dkstiler/printcart/check_waveform/README.txt

This actually is most bits of the esphttpd example code, hence references to un-used cats,
cgi scripts etc. The important bits are i2s_parallel.c and cgi-waveform.c.
