dkstiler/printcart/integrated/main/whe.png

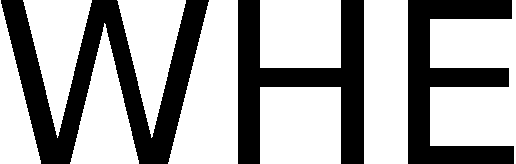
integrated/main/whe.png
