dkstiler/printcart/integrated/components/magicbrush/magicbrush-schematic.pdf

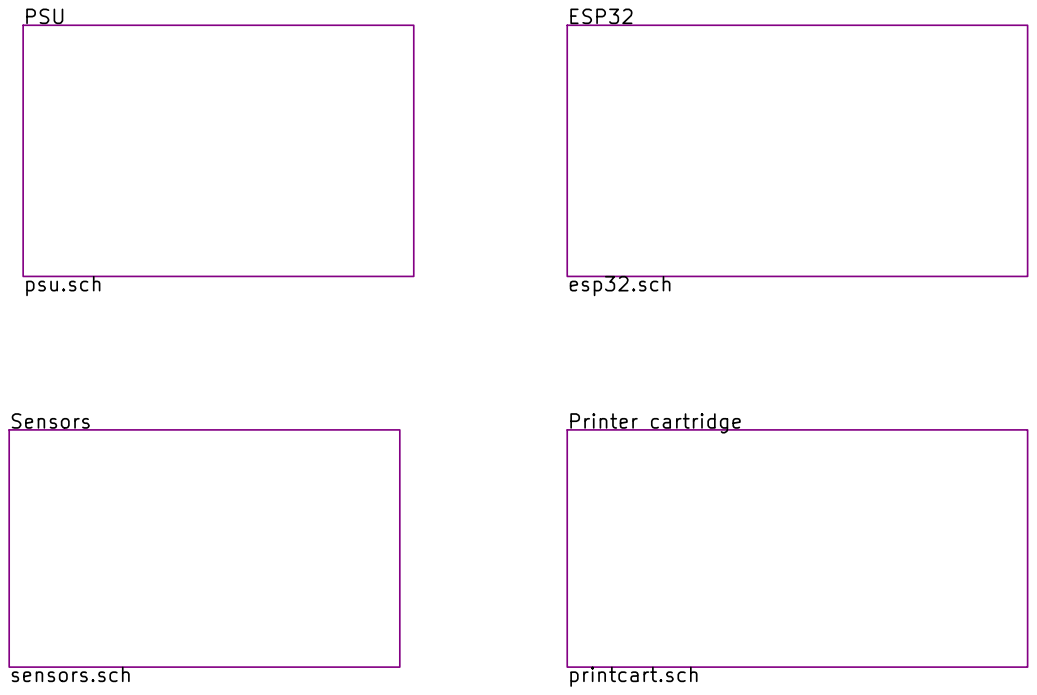
[picture p2: page 1]

File: magicbrush.sch Sheet: /
Id: 1/5 Title:

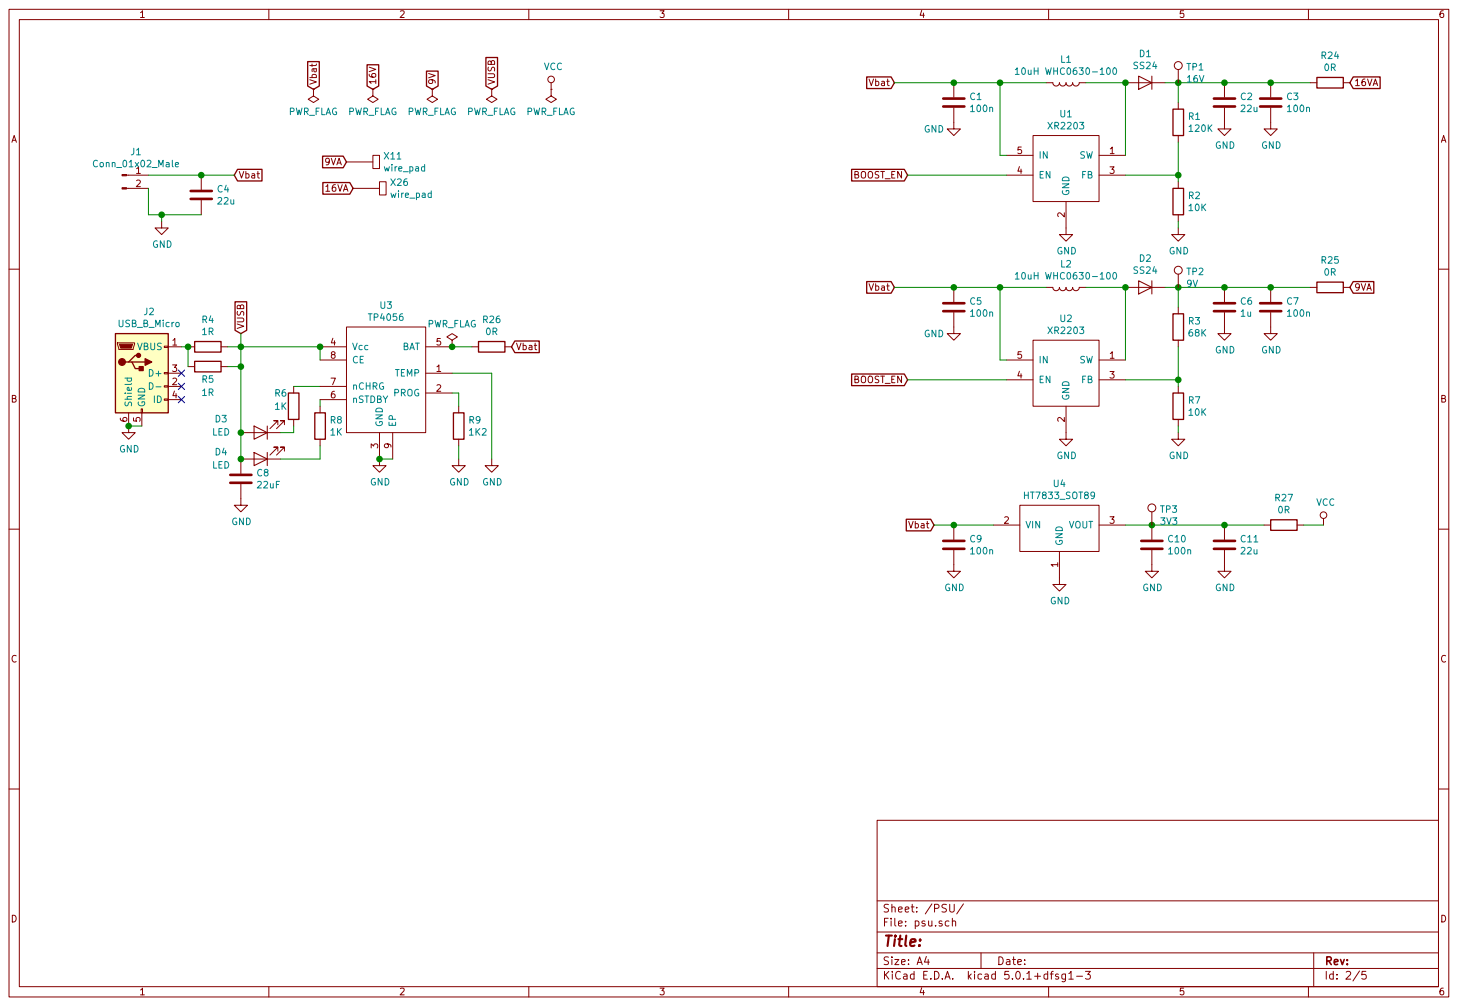
[picture p3: page 2]

File: psu.sch Sheet: /PSU/
Id: 2/5 Title:

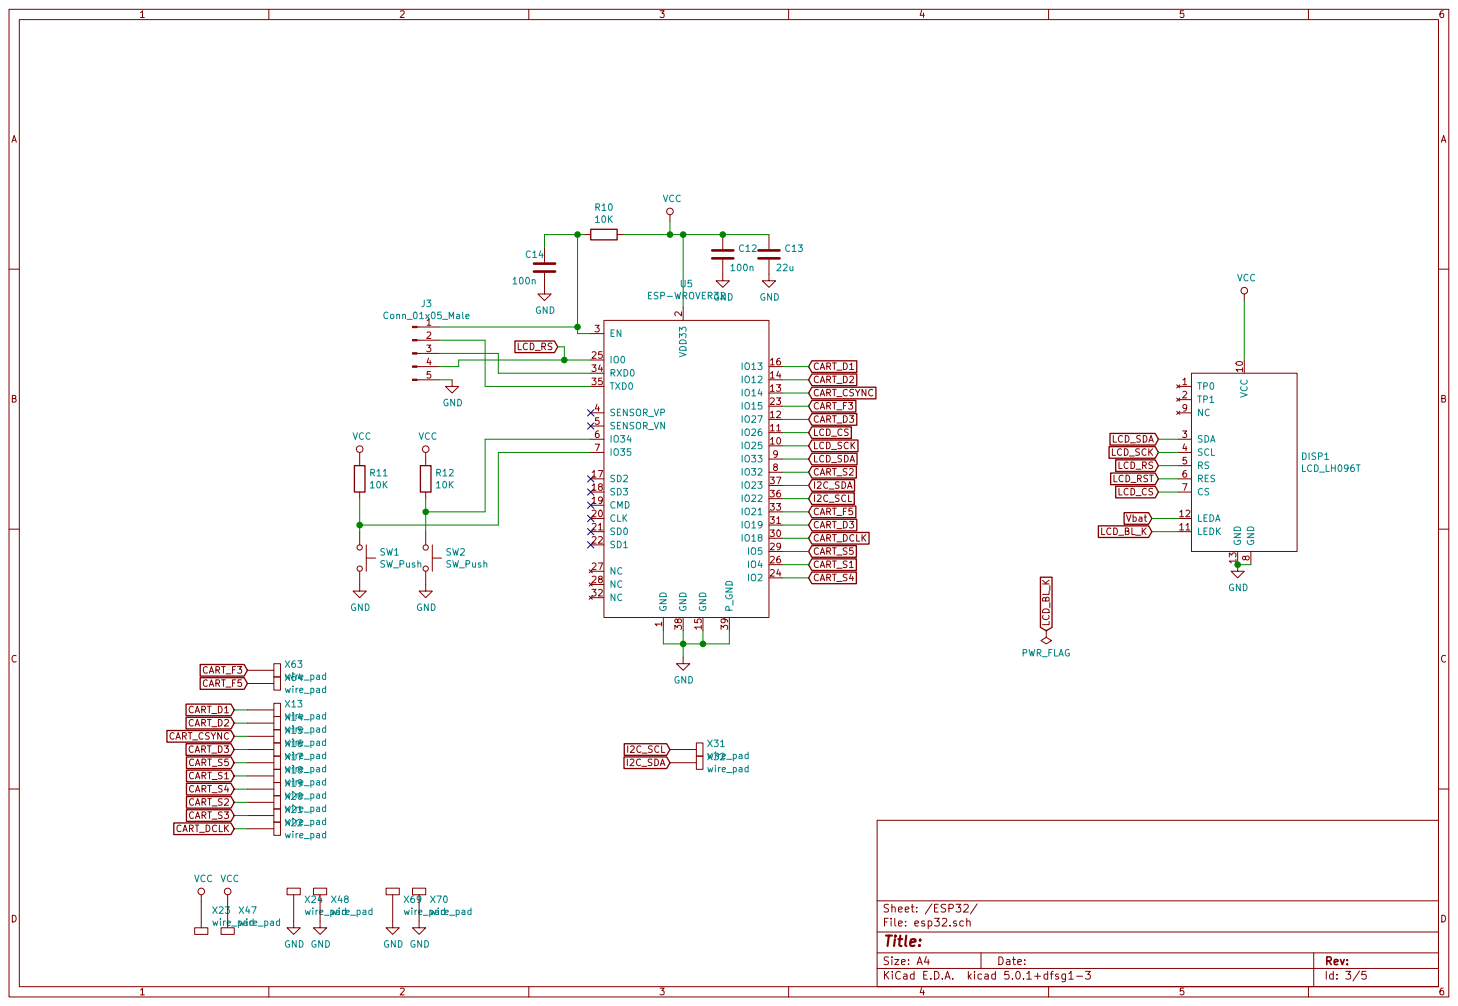
[picture p4: page 3]

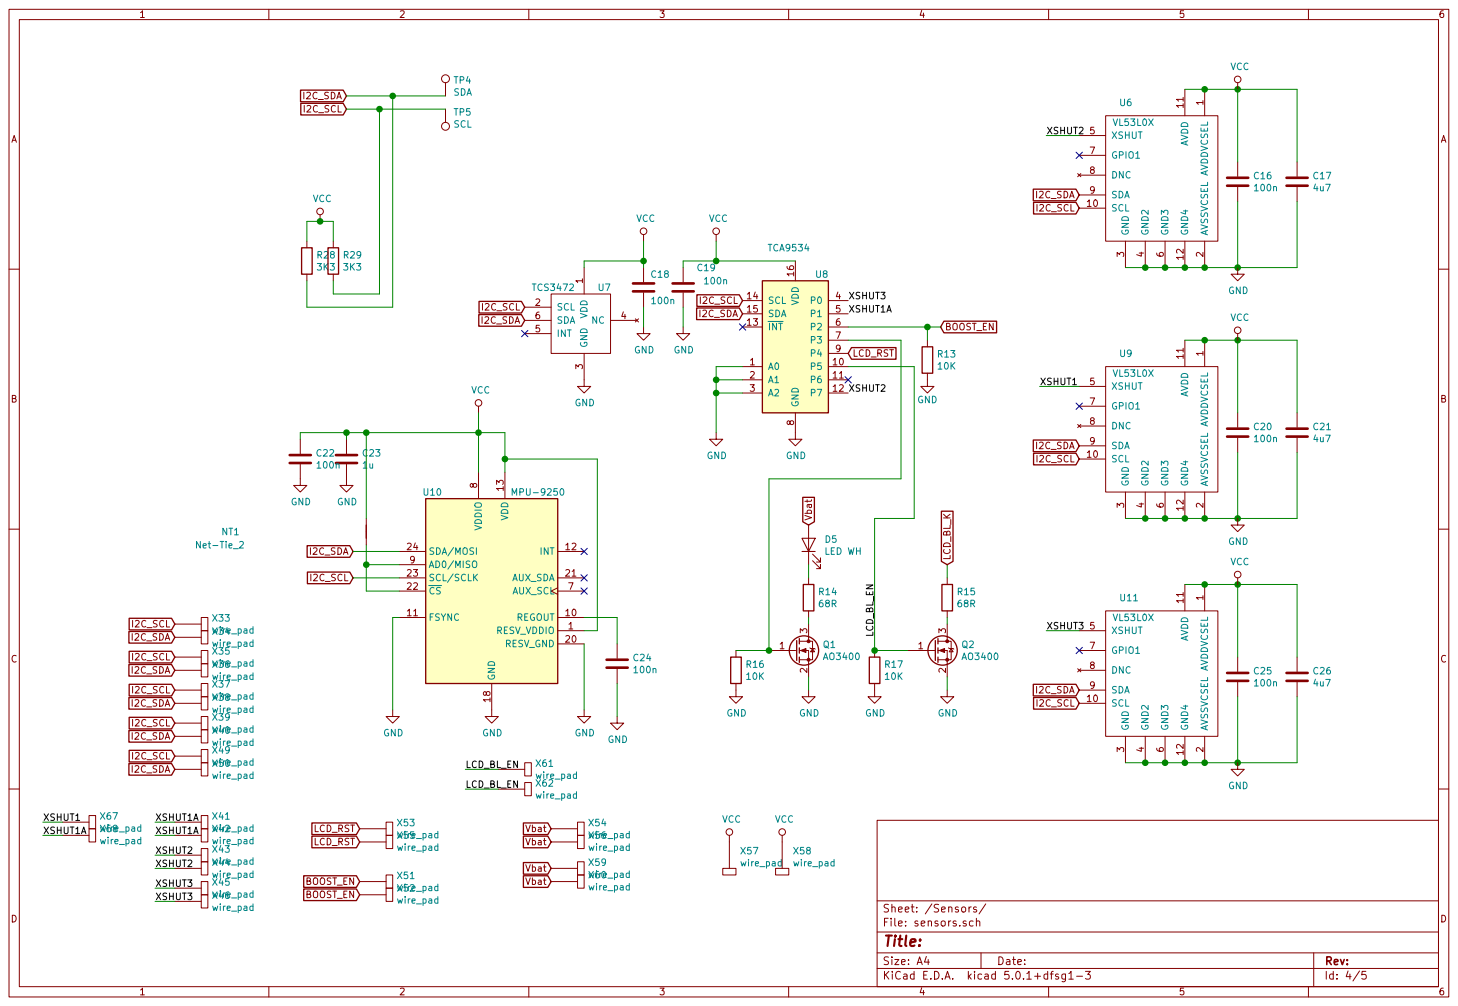
[picture p5: page 4]

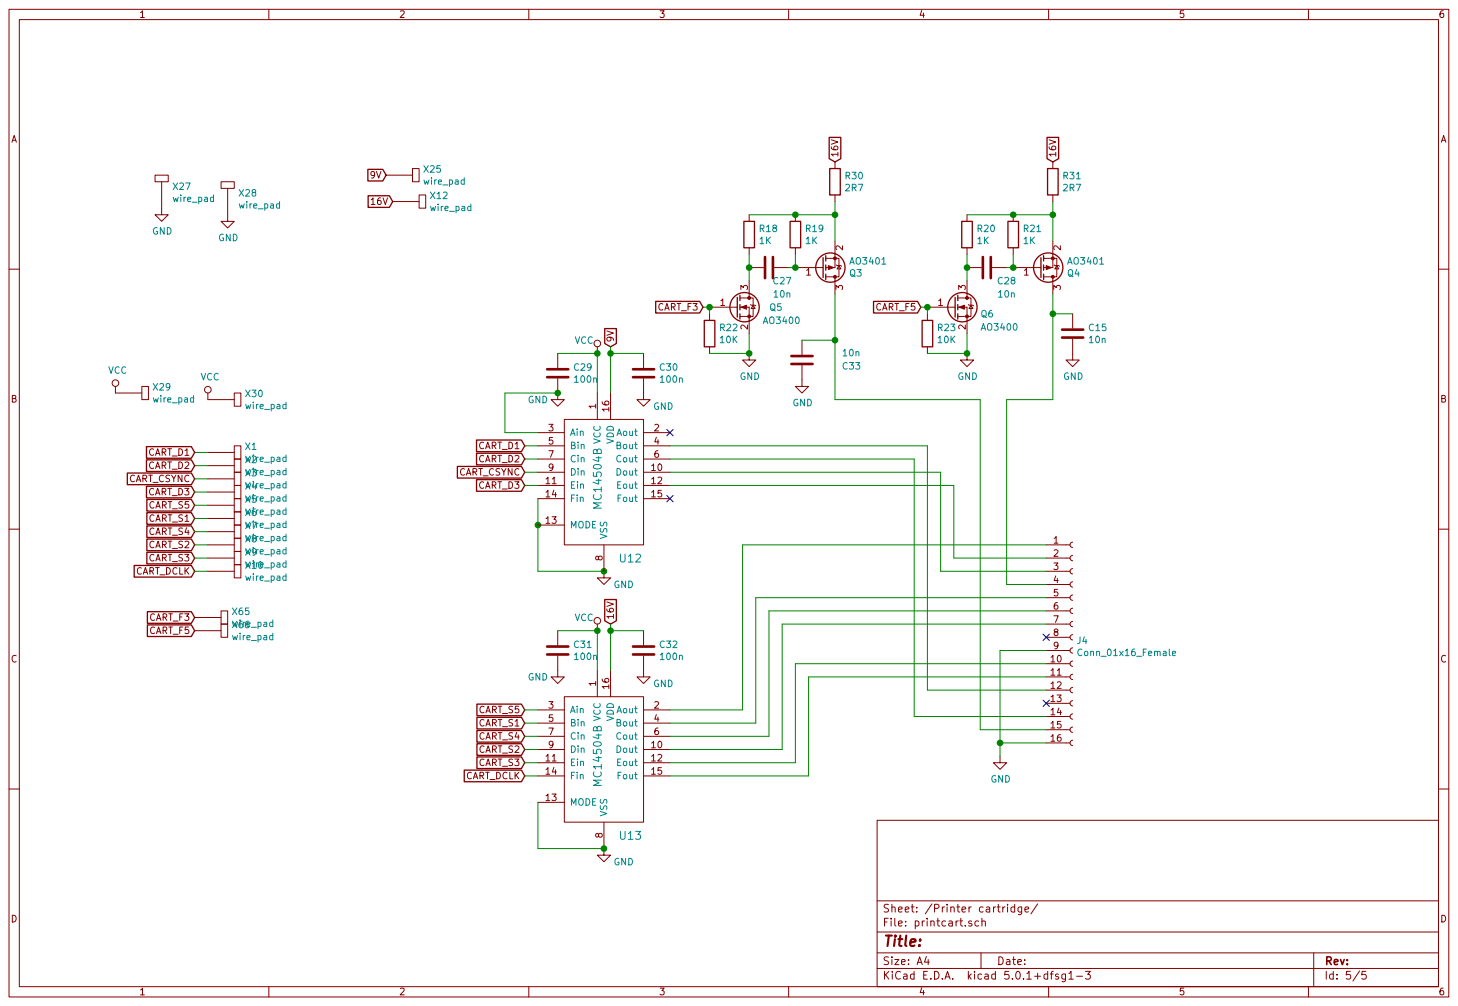
[picture p6: page 5]
