dkstiler/printcart/integrated/components/magicbrush/magicbrush.kicad_pcb

## KiCad design integrated/components/magicbrush/magicbrush.kicad_pcb (2025-09-18)

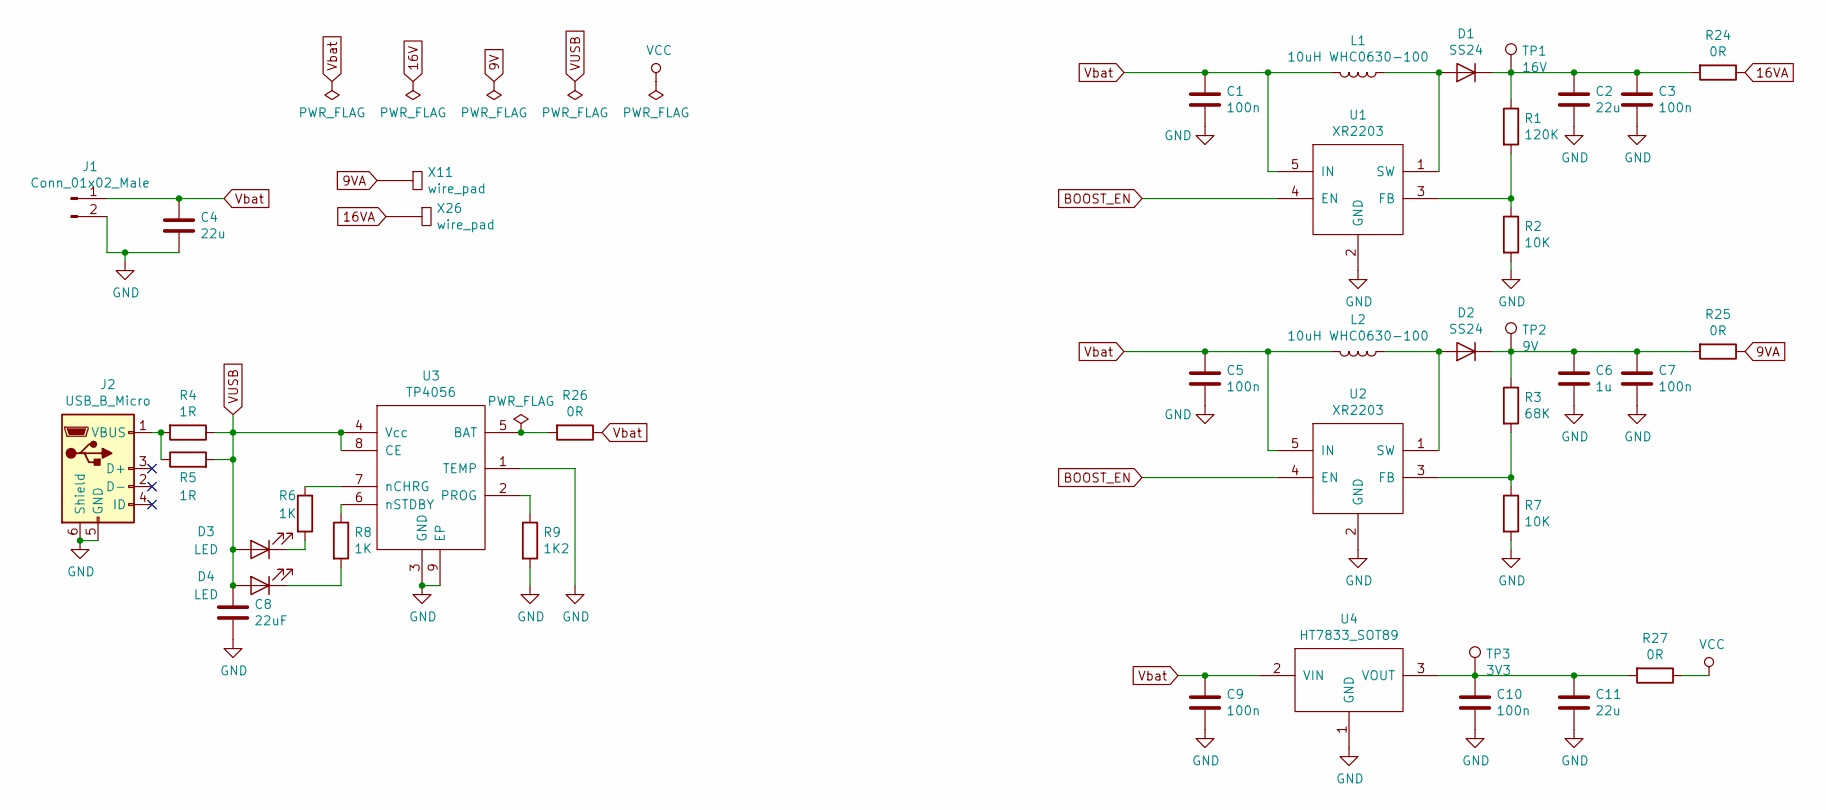
[picture p7: schematic psu.sch]

Parts:
C1, C3, C5, C7, C9, C10: 100n; C_0603_1608Metric_Pad1.05x0.95mm_HandSolder
C2, C4, C11: 22u; C_0805_2012Metric_Pad1.15x1.40mm_HandSolder
C6: 1u; C_0603_1608Metric_Pad1.05x0.95mm_HandSolder
C8: 22uF; C_0805_2012Metric_Pad1.15x1.40mm_HandSolder
D1, D2: SS24; D_SMB_Handsoldering
D3, D4: LED; LED_0603_1608Metric_Pad1.05x0.95mm_HandSolder
J1: Conn_01x02_Male; PinHeader_1x02_P2.54mm_Vertical
J2: USB_B_Micro; USB_Micro-B_0.8mm_taobao
L1, L2: 10uH WHC0630-100; IND_WHC0630
R1: 120K; R_0603_1608Metric
R2, R7: 10K; R_0603_1608Metric
R3: 68K; R_0603_1608Metric
R4, R5: 1R; R_0603_1608Metric
R6, R8: 1K; R_0603_1608Metric
R9: 1K2; R_0603_1608Metric
R24, R25, R26, R27: 0R; R_0603_1608Metric_Pad1.05x0.95mm_HandSolder
TP1: 16V; TestPoint_Pad_D1.5mm
TP2: 9V; TestPoint_Pad_D1.5mm
TP3: 3V3; TestPoint_Pad_D1.5mm
U1, U2: XR2203; SOT-23-5
U3: TP4056; SOIC-8-1EP_3.9x4.9mm_P1.27mm_EP2.35x2.35mm
U4: HT7833_SOT89; SOT-89-3
X11, X26: wire_pad; wire_pad_1mm

Connections:
9VA: R25.1, X11.1
16VA: R24.1, X26.1
BOOST_EN: U1.4 (EN), U2.4 (EN); also elsewhere on the board
unnamed: C2.1, C3.1, D1.1 (K), R1.1, R24.2, TP1.1
unnamed: C6.1, C7.1, D2.1 (K), R3.1, R25.2, TP2.1
unnamed: C10.1, C11.1, R27.2, TP3.1, U4.3 (VOUT)
unnamed: D1.2 (A), L1.1, U1.1 (SW)
unnamed: D2.2 (A), L2.1, U2.1 (SW)
unnamed: D3.1 (K), R6.2
unnamed: D4.1 (K), R8.2
unnamed: J2.1 (VBUS), R4.2, R5.1
unnamed: R1.2, R2.1, U1.3 (FB)
unnamed: R3.2, R7.1, U2.3 (FB)
unnamed: R6.1, U3.7 (nCHRG)
unnamed: R8.1, U3.6 (nSTDBY)
unnamed: R9.1, U3.2 (PROG)
unnamed: R26.2, U3.5 (BAT)
VCC: R27.1; also elsewhere on the board
VUSB: C8.1, D3.2 (A), D4.2 (A), R4.1, R5.2, U3.4 (Vcc), U3.8 (CE)
Vbat: C1.1, C4.1, C5.1, C9.1, J1.1, L1.2, L2.2, R26.1, U1.5 (IN), U2.5 (IN), U4.2 (VIN); also elsewhere on the board

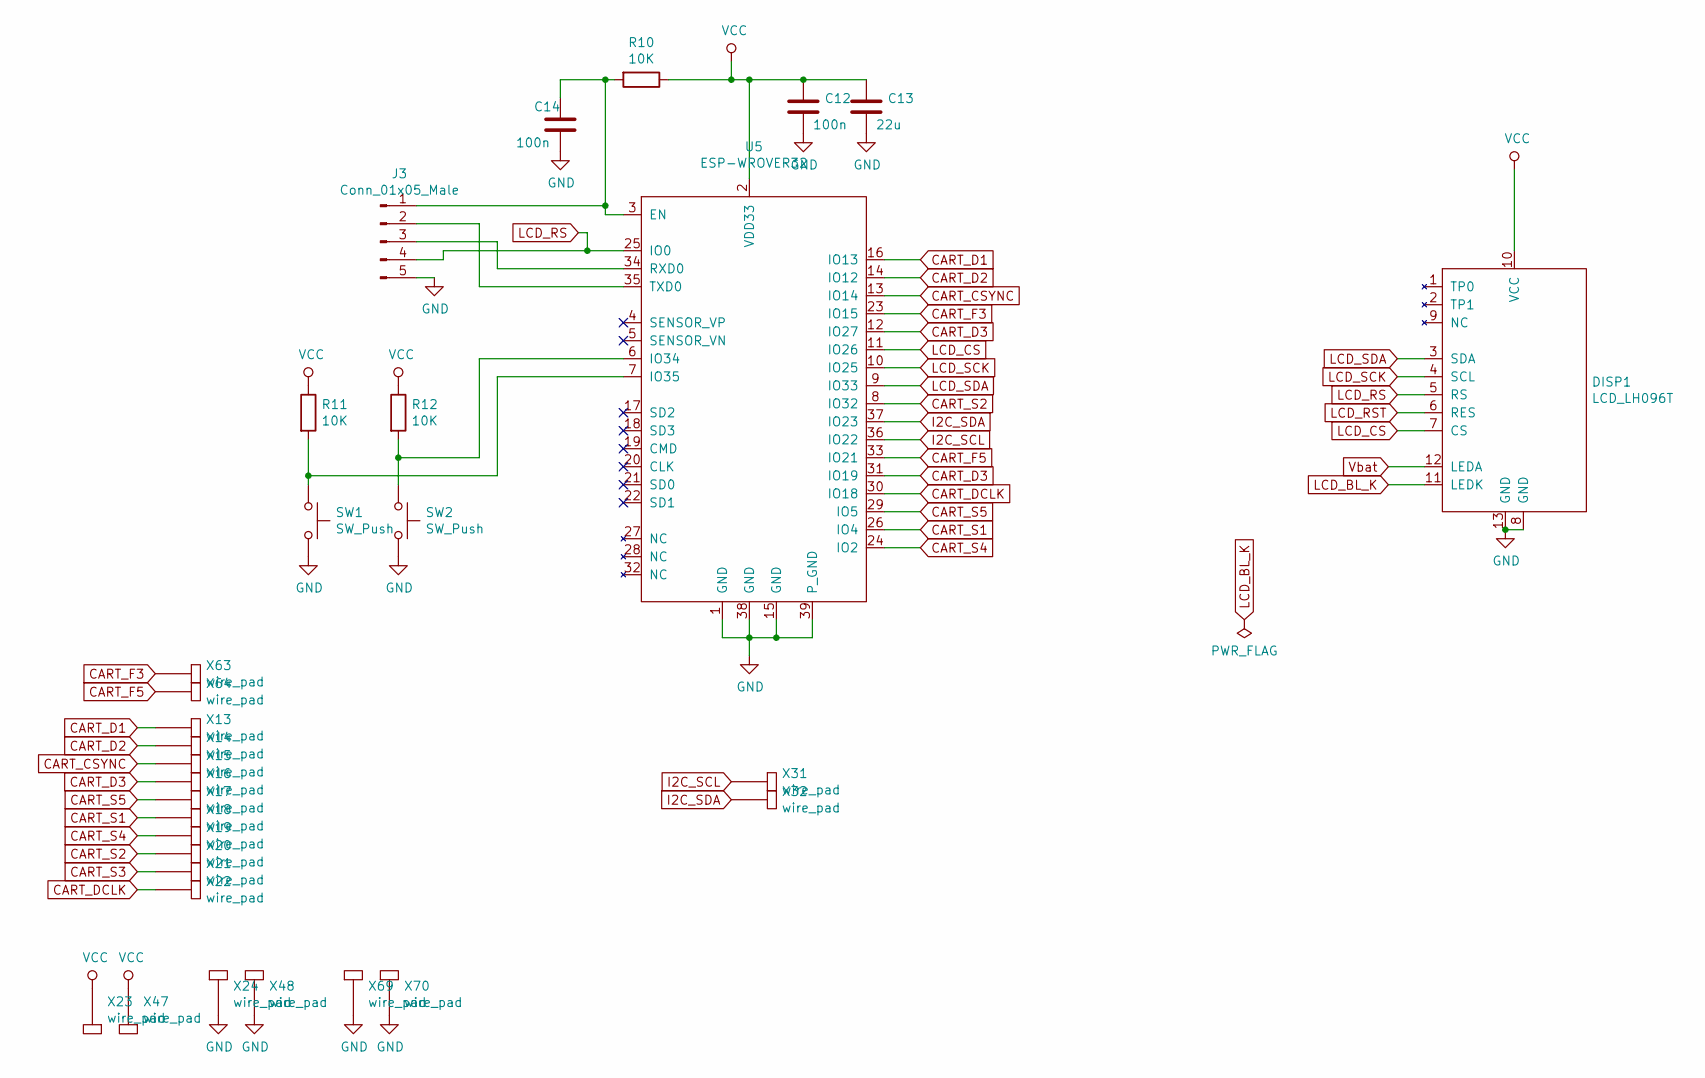
[picture p8: schematic esp32.sch]

Parts:
C12, C14: 100n; C_0603_1608Metric_Pad1.05x0.95mm_HandSolder
C13: 22u; C_0805_2012Metric_Pad1.15x1.40mm_HandSolder
DISP1: LCD_LH096T; LCD_LH086T
J3: Conn_01x05_Male; PinHeader_1x05_P2.54mm_Vertical
R10, R11, R12: 10K; R_0603_1608Metric
SW1, SW2: SW_Push; SW_PUSH_6mm
U5: ESP-WROVER32; ESP-WROVER-MOD
X13, X14, X15, X16, X17, X18, X19, X20, X21, X22, X31, X32, X63, X64: wire_pad; wire_pad_0.5mm
X23, X24, X47, X48, X69, X70: wire_pad; wire_pad_1mm

Connections:
CART_CSYNC: U5.13 (IO14), X15.1; also elsewhere on the board
CART_D1: U5.16 (IO13), X13.1; also elsewhere on the board
CART_D2: U5.14 (IO12), X14.1; also elsewhere on the board
CART_DCLK: U5.30 (IO18), X22.1; also elsewhere on the board
CART_F3: U5.23 (IO15), X63.1; also elsewhere on the board
CART_F5: U5.33 (IO21), X64.1; also elsewhere on the board
CART_S1: U5.26 (IO4), X18.1; also elsewhere on the board
CART_S2: U5.8 (IO32), X20.1; also elsewhere on the board
CART_S4: U5.24 (IO2), X19.1; also elsewhere on the board
CART_S5: U5.29 (IO5), X17.1; also elsewhere on the board
I2C_SCL: U5.36 (IO22), X31.1; also elsewhere on the board
I2C_SDA: U5.37 (IO23), X32.1; also elsewhere on the board
LCD_BL_K: DISP1.11 (LEDK); also elsewhere on the board
LCD_CS: DISP1.7 (CS), U5.11 (IO26)
LCD_RS: DISP1.5 (RS), J3.4, U5.25 (IO0)
LCD_RST: DISP1.6 (RES); also elsewhere on the board
LCD_SCK: DISP1.4 (SCL), U5.10 (IO25)
LCD_SDA: DISP1.3 (SDA), U5.9 (IO33)
unnamed: C14.1, J3.1, R10.2, U5.3 (EN)
unnamed: J3.2, U5.35 (TXD0)
unnamed: J3.3, U5.34 (RXD0)
unnamed: R11.2, SW1.1, U5.7 (IO35)
unnamed: R12.2, SW2.1, U5.6 (IO34)
VCC: C12.1, C13.1, DISP1.10 (VCC), R10.1, R11.1, R12.1, U5.2 (VDD33), X23.1, X47.1; also elsewhere on the board
Vbat: DISP1.12 (LEDA); also elsewhere on the board

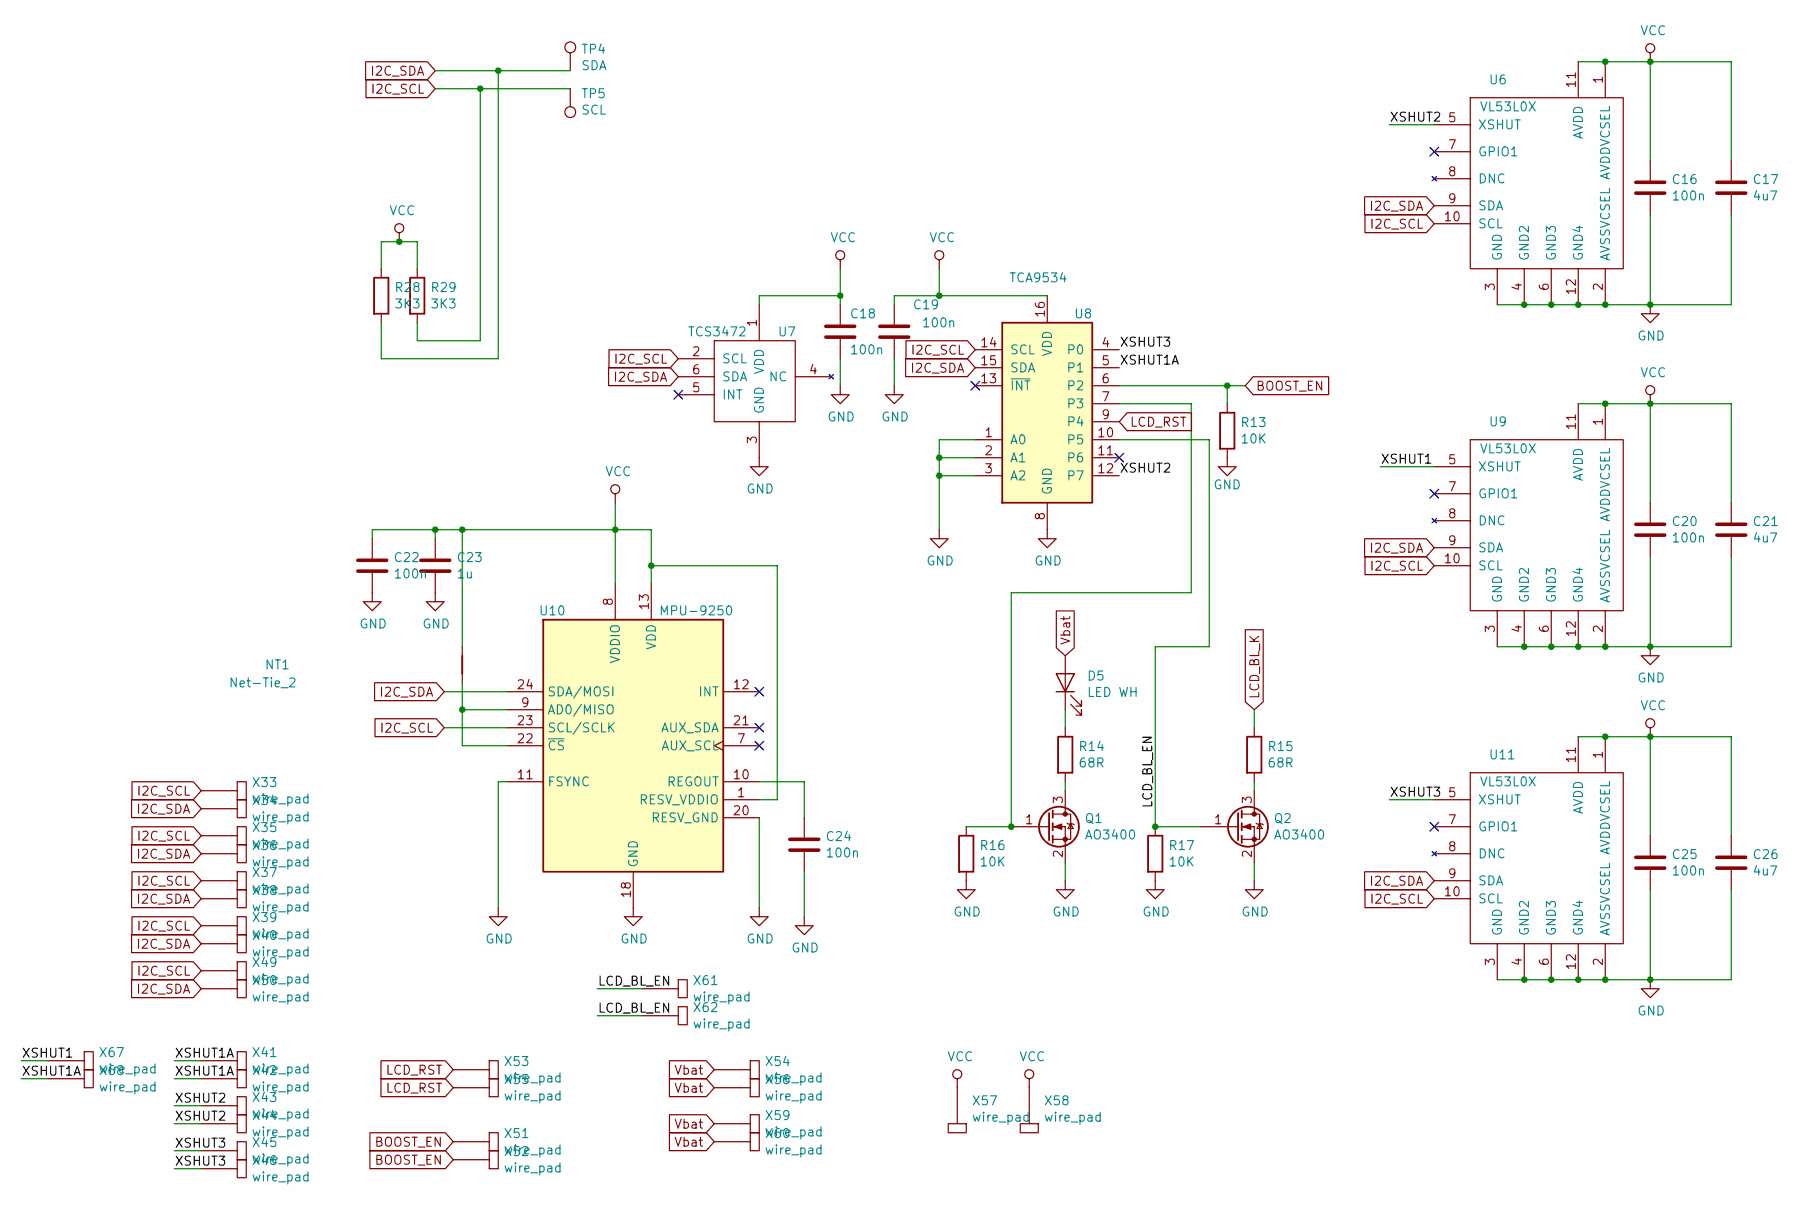
[picture p9: schematic sensors.sch]

Parts:
C16, C18, C19, C20, C22, C24, C25: 100n; C_0603_1608Metric_Pad1.05x0.95mm_HandSolder
C17, C21, C26: 4u7; C_0805_2012Metric_Pad1.15x1.40mm_HandSolder
C23: 1u; C_0603_1608Metric_Pad1.05x0.95mm_HandSolder
D5: LED WH; LED_0603_1608Metric_Pad1.05x0.95mm_HandSolder
NT1: Net-Tie_2; NetTie-2_THT_Pad0.3mm
Q1, Q2: AO3400; SOT-23
R13, R16, R17: 10K; R_0603_1608Metric
R14, R15: 68R; R_0603_1608Metric
R28, R29: 3K3; R_0603_1608Metric
TP4: SDA; TestPoint_Pad_D1.5mm
TP5: SCL; TestPoint_Pad_D1.5mm
U6, U9, U11: VL53L0X; VL53LxX
U7: TCS3472; DFNL_FN_TCS3472
U8: TCA9534; TSSOP-16_4.4x5mm_P0.65mm
U10: MPU-9250; QFN-24_3x3mm_P0.4mm
X33, X34, X35, X36, X37, X38, X39, X40, X41, X42, X43, X44, X45, X46, X49, X50, X51, X52, X53, X54, X55, X56, X59, X60, X61, X62, X67, X68: wire_pad; wire_pad_0.5mm
X57, X58: wire_pad; wire_pad_1mm

Connections:
/Sensors/LCD_BL_EN: Q2.1 (G), R17.1, U8.10 (P5), X61.1, X62.1
/Sensors/XSHUT1: U9.5 (XSHUT), X67.1
/Sensors/XSHUT1A: U8.5 (P1), X41.1, X42.1, X68.1
/Sensors/XSHUT2: U6.5 (XSHUT), U8.12 (P7), X43.1, X44.1
/Sensors/XSHUT3: U8.4 (P0), U11.5 (XSHUT), X45.1, X46.1
BOOST_EN: R13.1, U8.6 (P2), X51.1, X52.1; also elsewhere on the board
I2C_SCL: R29.2, TP5.1, U6.10 (SCL), U7.2 (SCL), U8.14 (SCL), U9.10 (SCL), U10.23 (SCL/SCLK), U11.10 (SCL), X33.1, X35.1, X37.1, X39.1, X49.1; also elsewhere on the board
I2C_SDA: R28.2, TP4.1, U6.9 (SDA), U7.6 (SDA), U8.15 (SDA), U9.9 (SDA), U10.24 (SDA/MOSI), U11.9 (SDA), X34.1, X36.1, X38.1, X40.1, X50.1; also elsewhere on the board
LCD_BL_K: R15.1; also elsewhere on the board
LCD_RST: U8.9 (P4), X53.1, X55.1; also elsewhere on the board
unnamed: C24.1, U10.10 (REGOUT)
unnamed: D5.1 (K), R14.1
unnamed: NT1.2, U10.9 (AD0/MISO), U10.22 (~CS)
unnamed: Q1.1 (G), R16.1, U8.7 (P3)
unnamed: Q1.3 (D), R14.2
unnamed: Q2.3 (D), R15.2
VCC: C16.1, C17.1, C18.1, C19.1, C20.1, C21.1, C22.1, C23.1, C25.1, C26.1, NT1.1, R28.1, R29.1, U6.1 (AVDDVCSEL), U6.11 (AVDD), U7.1 (VDD), U8.16 (VDD), U9.1 (AVDDVCSEL), U9.11 (AVDD), U10.1 (RESV_VDDIO), U10.8 (VDDIO), U10.13 (VDD), U11.1 (AVDDVCSEL), U11.11 (AVDD), X57.1, X58.1; also elsewhere on the board
Vbat: D5.2 (A), X54.1, X56.1, X59.1, X60.1; also elsewhere on the board

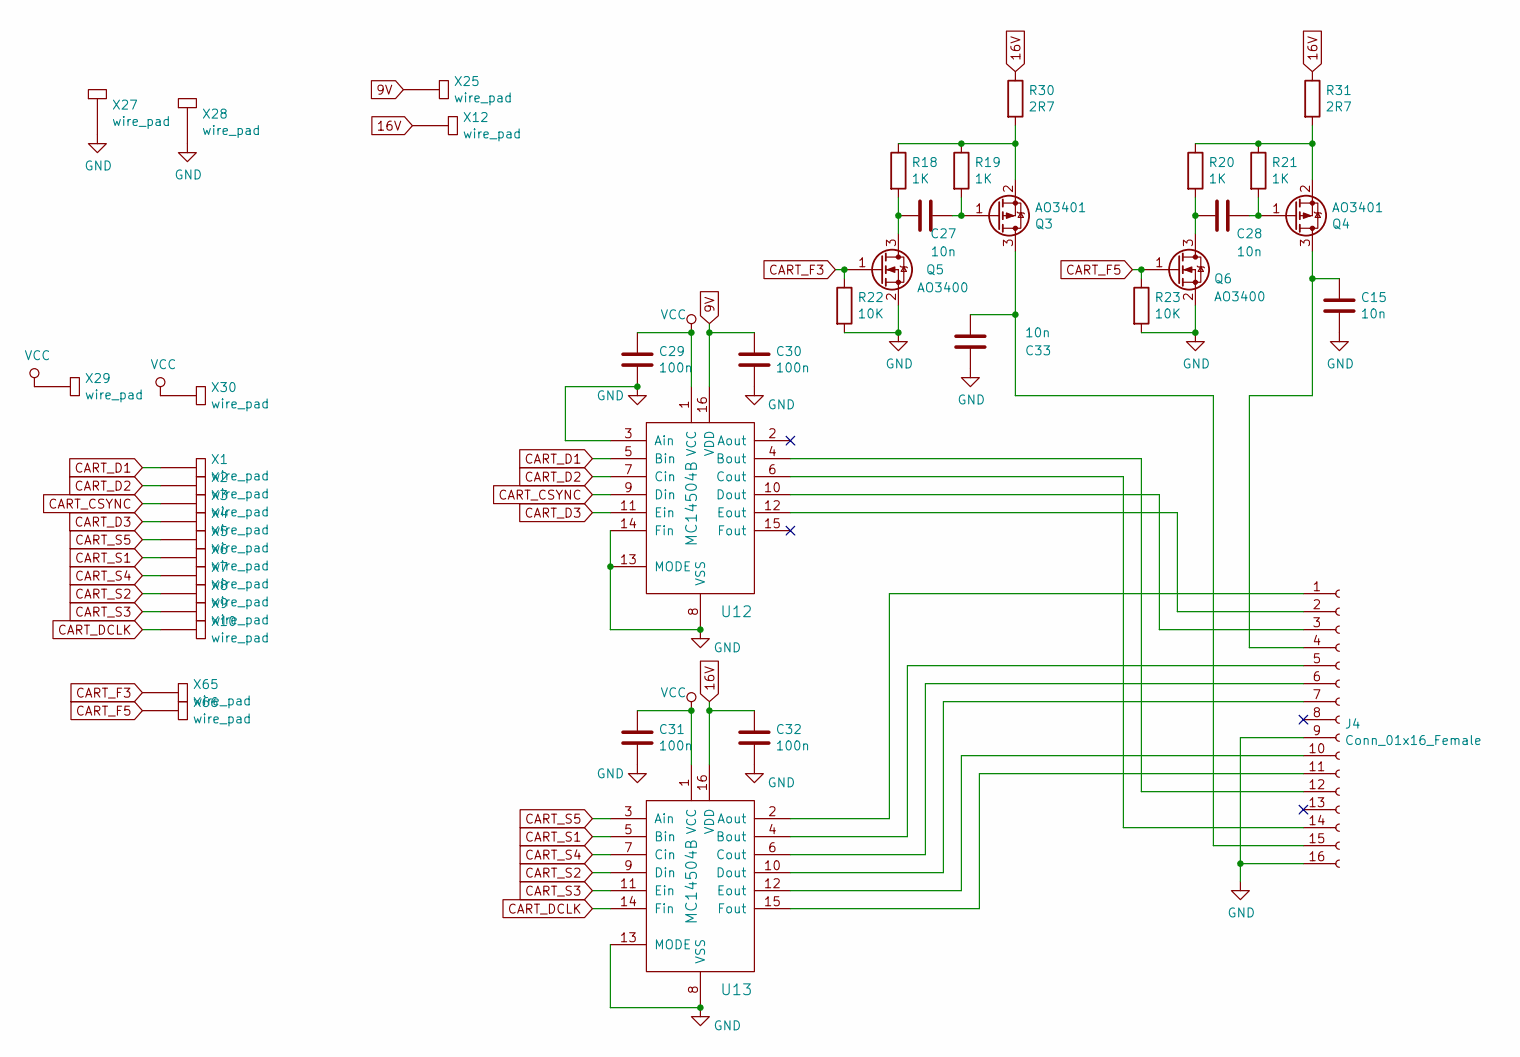
[picture p10: schematic printcart.sch]

Parts:
C15, C27, C28, C33: 10n; C_0603_1608Metric_Pad1.05x0.95mm_HandSolder
C29, C30, C31, C32: 100n; C_0603_1608Metric_Pad1.05x0.95mm_HandSolder
J4: Conn_01x16_Female; HP_803_CART
Q3, Q4: AO3401; SOT-23
Q5, Q6: AO3400; SOT-23
R18, R19, R20, R21: 1K; R_0603_1608Metric
R22, R23: 10K; R_0603_1608Metric
R30, R31: 2R7; R_0603_1608Metric
U12, U13: MC14504B; SOIC-16_3.9x9.9mm_P1.27mm
X1, X2, X3, X4, X5, X6, X7, X8, X9, X10, X65, X66: wire_pad; wire_pad_0.5mm
X12, X25, X27, X28, X29, X30: wire_pad; wire_pad_1mm

Connections:
9V: C30.1, U12.16 (VDD), X25.1
16V: C32.1, R30.1, R31.1, U13.16 (VDD), X12.1
CART_CSYNC: U12.9 (Din), X3.1; also elsewhere on the board
CART_D1: U12.5 (Bin), X1.1; also elsewhere on the board
CART_D2: U12.7 (Cin), X2.1; also elsewhere on the board
CART_DCLK: U13.14 (Fin), X10.1; also elsewhere on the board
CART_F3: Q5.1 (G), R22.1, X65.1; also elsewhere on the board
CART_F5: Q6.1 (G), R23.1, X66.1; also elsewhere on the board
CART_S1: U13.5 (Bin), X6.1; also elsewhere on the board
CART_S2: U13.9 (Din), X8.1; also elsewhere on the board
CART_S4: U13.7 (Cin), X7.1; also elsewhere on the board
CART_S5: U13.3 (Ain), X5.1; also elsewhere on the board
unnamed: C15.1, J4.4, Q4.3 (D)
unnamed: C27.1, Q3.1 (G), R19.2
unnamed: C27.2, Q5.3 (D), R18.2
unnamed: C28.1, Q4.1 (G), R21.2
unnamed: C28.2, Q6.3 (D), R20.2
unnamed: J4.1, U13.2 (Aout)
unnamed: J4.2, U12.12 (Eout)
unnamed: J4.3, U12.10 (Dout)
unnamed: J4.5, U13.4 (Bout)
unnamed: J4.6, U13.6 (Cout)
unnamed: J4.7, U13.10 (Dout)
unnamed: J4.10, U13.12 (Eout)
unnamed: J4.11, U13.15 (Fout)
unnamed: J4.12, U12.4 (Bout)
unnamed: J4.14, U12.6 (Cout)
unnamed: Q3.2 (S), R18.1, R19.1, R30.2
unnamed: Q4.2 (S), R20.1, R21.1, R31.2
VCC: C29.1, C31.1, U12.1 (VCC), U13.1 (VCC), X29.1, X30.1; also elsewhere on the board

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
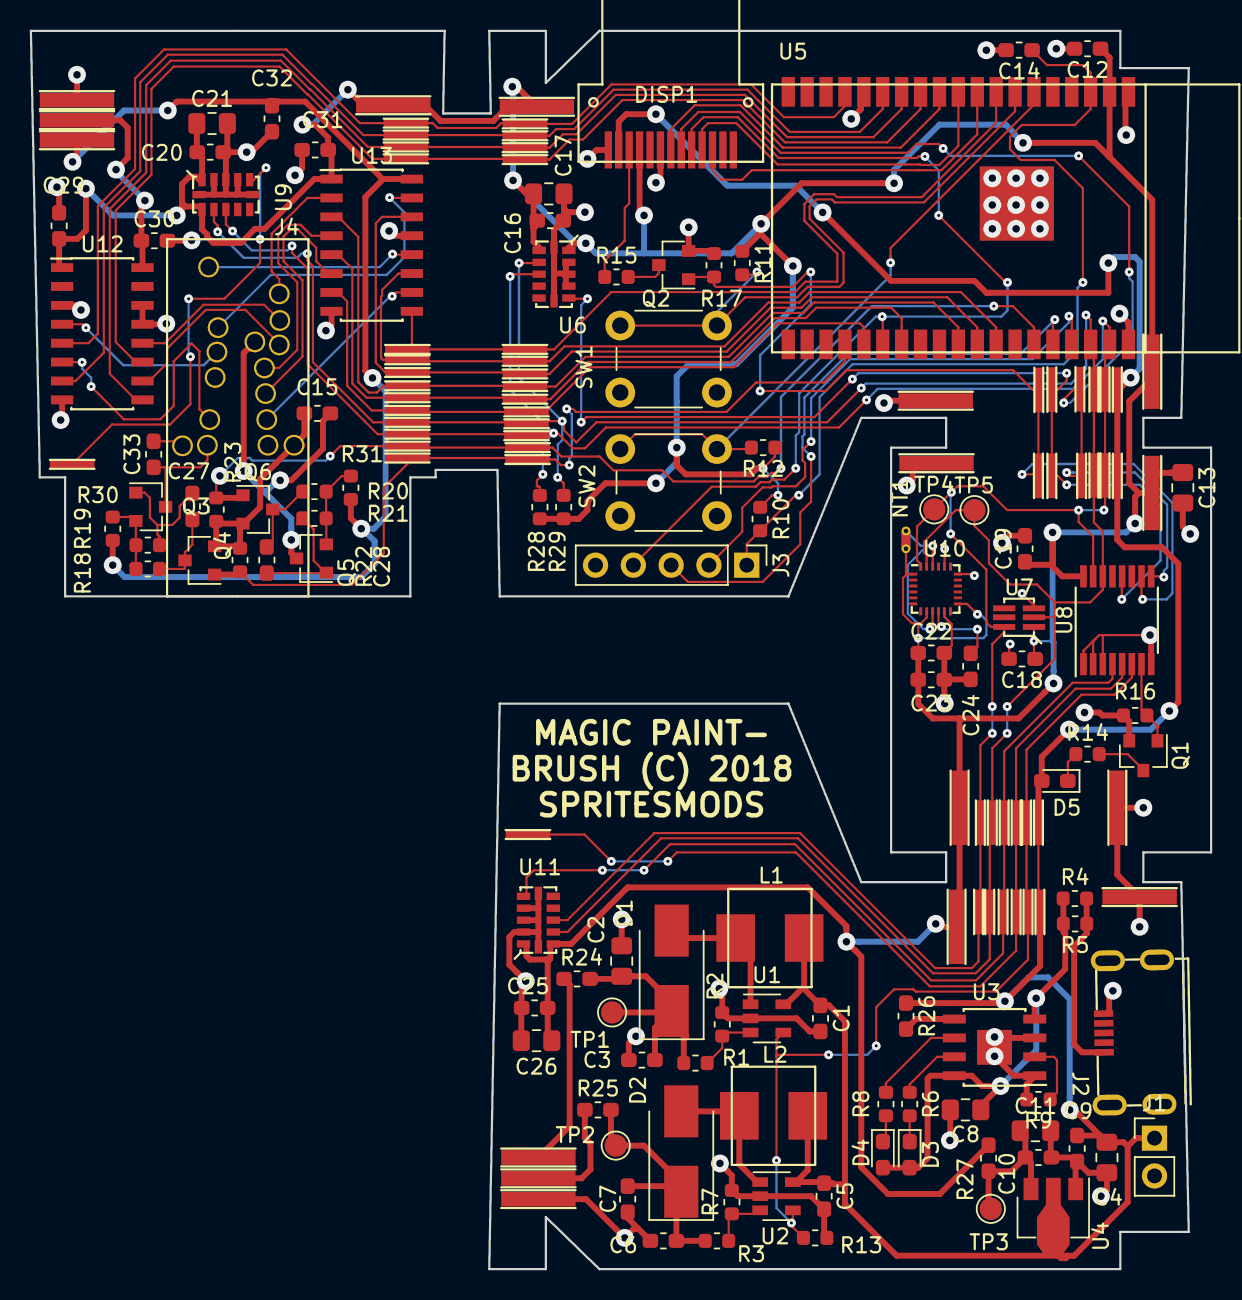
[picture p11: board magicbrush.kicad_pcb from above]

Board: 2 copper layers, 79.3 x 83.2 mm, 173 parts (0 on the bottom side), 77 nets.
