dkstiler/printcart/check_waveform/main/main.c

/*
 * ----------------------------------------------------------------------------
 * "THE BEER-WARE LICENSE" (Revision 42):
 * Jeroen Domburg <jeroen@spritesmods.com> wrote this file. As long as you retain 
 * this notice you can do whatever you want with this stuff. If we meet some day, 
 * and you think this stuff is worth it, you can buy me a beer in return. 
 * ----------------------------------------------------------------------------
 */

#include <esp8266.h>
#include "httpd.h"
#include "io.h"
#include "httpdespfs.h"
#include "cgi.h"
#include "cgiwifi.h"
#include "cgiflash.h"
#include "auth.h"
#include "espfs.h"
#include "captdns.h"
#include "webpages-espfs.h"
#include "cgiwebsocket.h"
#include "cgi-test.h"

#include "freertos/FreeRTOS.h"
#include "freertos/task.h"
#include "freertos/semphr.h"
#include "freertos/queue.h"

#include "esp_wifi.h"
#include "esp_system.h"
#include "esp_event.h"
#include "esp_event_loop.h"
#include "nvs_flash.h"
#include "driver/gpio.h"
#include "cgi-waveform.h"

#include "soc/timer_group_struct.h"

esp_err_t event_handler(void *ctx, system_event_t *event)
{
    return ESP_OK;
}


//Function that tells the authentication system what users/passwords live on the system.
//This is disabled in the default build; if you want to try it, enable the authBasic line in
//the builtInUrls below.
int myPassFn(HttpdConnData *connData, int no, char *user, int userLen, char *pass, int passLen) {
	if (no==0) {
		strcpy(user, "admin");
		strcpy(pass, "s3cr3t");
		return 1;
//Add more users this way. Check against incrementing no for each user added.
//	} else if (no==1) {
//		strcpy(user, "user1");
//		strcpy(pass, "something");
//		return 1;
	}
	return 0;
}



//Broadcast the uptime in seconds every second over connected websockets
static void websocketBcast(void *arg) {
	static int ctr=0;
	char buff[128];
	while(1) {
		ctr++;
		sprintf(buff, "Up for %d minutes %d seconds!\n", ctr/60, ctr%60);
		cgiWebsockBroadcast("/websocket/ws.cgi", buff, strlen(buff), WEBSOCK_FLAG_NONE);
		vTaskDelay(1000/portTICK_RATE_MS);
	}
}

//On reception of a message, send "You sent: " plus whatever the other side sent
static void myWebsocketRecv(Websock *ws, char *data, int len, int flags) {
	int i;
	char buff[128];
	sprintf(buff, "You sent: ");
	for (i=0; i<len; i++) buff[i+10]=data[i];
	buff[i+10]=0;
	cgiWebsocketSend(ws, buff, strlen(buff), WEBSOCK_FLAG_NONE);
}

//Websocket connected. Install reception handler and send welcome message.
static void myWebsocketConnect(Websock *ws) {
	ws->recvCb=myWebsocketRecv;
	cgiWebsocketSend(ws, "Hi, Websocket!", 14, WEBSOCK_FLAG_NONE);
}

//On reception of a message, echo it back verbatim
void myEchoWebsocketRecv(Websock *ws, char *data, int len, int flags) {
	printf("EchoWs: echo, len=%d\n", len);
	cgiWebsocketSend(ws, data, len, flags);
}

//Echo websocket connected. Install reception handler.
void myEchoWebsocketConnect(Websock *ws) {
	printf("EchoWs: connect\n");
	ws->recvCb=myEchoWebsocketRecv;
}

CgiUploadFlashDef uploadParams={
	.type=CGIFLASH_TYPE_FW,
#ifndef ESP32
	.fw1Pos=0x1000,
	.fw2Pos=((OTA_FLASH_SIZE_K*1024)/2)+0x1000,
	.fwSize=((OTA_FLASH_SIZE_K*1024)/2)-0x1000,
	.tagName=OTA_TAGNAME
#endif
};


/*
This is the main url->function dispatching data struct.
In short, it's a struct with various URLs plus their handlers. The handlers can
be 'standard' CGI functions you wrote, or 'special' CGIs requiring an argument.
They can also be auth-functions. An asterisk will match any url starting with
everything before the asterisks; "*" matches everything. The list will be
handled top-down, so make sure to put more specific rules above the more
general ones. Authorization things (like authBasic) act as a 'barrier' and
should be placed above the URLs they protect.
*/
HttpdBuiltInUrl builtInUrls[]={
	{"*", cgiRedirectApClientToHostname, "esp8266.nonet"},
	{"/", cgiRedirect, "/index.html"},
	{"/led.tpl", cgiEspFsTemplate, tplLed},
	{"/index.tpl", cgiEspFsTemplate, tplCounter},
	{"/led.cgi", cgiLed, NULL},
	{"/waveform.cgi", cgiWaveform, NULL},
	{"/flash/", cgiRedirect, "/flash/index.html"},
	{"/flash/next", cgiGetFirmwareNext, &uploadParams},
	{"/flash/upload", cgiUploadFirmware, &uploadParams},
	{"/flash/reboot", cgiRebootFirmware, NULL},
	//Routines to make the /wifi URL and everything beneath it work.

//Enable the line below to protect the WiFi configuration with an username/password combo.
//	{"/wifi/*", authBasic, myPassFn},

	{"/wifi", cgiRedirect, "/wifi/wifi.tpl"},
	{"/wifi/", cgiRedirect, "/wifi/wifi.tpl"},
	{"/wifi/wifiscan.cgi", cgiWiFiScan, NULL},
	{"/wifi/wifi.tpl", cgiEspFsTemplate, tplWlan},
	{"/wifi/connect.cgi", cgiWiFiConnect, NULL},
	{"/wifi/connstatus.cgi", cgiWiFiConnStatus, NULL},
	{"/wifi/setmode.cgi", cgiWiFiSetMode, NULL},

	{"/websocket/ws.cgi", cgiWebsocket, myWebsocketConnect},
	{"/websocket/echo.cgi", cgiWebsocket, myEchoWebsocketConnect},

	{"/test", cgiRedirect, "/test/index.html"},
	{"/test/", cgiRedirect, "/test/index.html"},
	{"/test/test.cgi", cgiTestbed, NULL},

	{"*", cgiEspFsHook, NULL}, //Catch-all cgi function for the filesystem
	{NULL, NULL, NULL}
};


//Main routine. Initialize stdout, the I/O, filesystem and the webserver and we're done.
int app_main(void)
{
    nvs_flash_init();
    system_init();
    tcpip_adapter_init();
    ESP_ERROR_CHECK( esp_event_loop_init(event_handler, NULL) );
    wifi_init_config_t cfg = WIFI_INIT_CONFIG_DEFAULT();
    ESP_ERROR_CHECK( esp_wifi_init(&cfg) );
    ESP_ERROR_CHECK( esp_wifi_set_storage(WIFI_STORAGE_RAM) );
    ESP_ERROR_CHECK( esp_wifi_set_mode(WIFI_MODE_STA) );
    wifi_config_t sta_config = {
        .sta = {
            .ssid = "Sprite",
            .password = "pannenkoek",
            .bssid_set = false
        }
    };
    ESP_ERROR_CHECK( esp_wifi_set_config(WIFI_IF_STA, &sta_config) );
    ESP_ERROR_CHECK( esp_wifi_start() );
    ESP_ERROR_CHECK( esp_wifi_connect() );


	ioInit();
//	captdnsInit();

	espFsInit((void*)(webpages_espfs_start));
	httpdInit(builtInUrls, 80);


	cgiWaveformInit();
	printf("\nReady\n");

    return 0;
}
