dkstiler/printcart/integrated/components/printcart/printcart_genwaveform.h

void printcart_line_clear(uint8_t *l);
void printcart_line_set_pixel(uint8_t *l, int p, int col);
void printcart_line_set_pixel_mono(uint8_t *l, int p, int row);
int printcart_add_waveform(uint16_t *w, const uint16_t *tp, const uint8_t *c, const uint8_t *m, const uint8_t *y, int l);
