dkstiler/printcart/(commit log)

2018-06-10 Wfmdec: un-frazzle bit-order. ESP32: encode graphics now
2018-09-10 Figured out power use, more notes
2018-09-11 Kinda works, but middle nozzles are not very enthousiastic...
2018-09-14 IT PRINTS!!!!
2018-09-14 Better nozzle thing
2018-09-14 IT WORKS! Sooo happy. The Nyancat prints.
2018-10-19 Add integrated PCB firmware. Distance sensor, LCD, color sensor, MPU all work.
2018-10-20 All sensors work.
2018-10-27 Added webserver to nyancat test; finally fix waveform to work on portable unit as well
    [cgi-waveform.c, main.c, printcart_genwaveform.c, printcart_i2s.c, printcart_i2s.h, webserver.c]
2018-11-01 Final update: lots of hackery to get some quick and dirty effects going.
    [partitions.csv]
2018-11-17 Attempt at IMU/ToF magic; wfmdec decodes black cartridges as well
2018-11-18 Add b/w cart support (hackish, needs different wf for now that needs editing of sources). Still some pixel order issues, but nothing major.
    [main.c, pixelpusher.c, pixelpusher.h, printcart_genwaveform.c, printcart_genwaveform.h, printcart_i2s.c]
2025-09-18 add pcb files
    [esp32.sch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]
