dkstiler/printcart/(notices)

Notices in the files:
integrated/components/magicbrush/magicbrush.kicad_pcb:
BRUSH (C) 2018
